pvginkel/Intercom/README.md

# TODO

- BLink lights during startup.
- Blink lights on failure.

# Pin assignment

PB = purple = 33
LR = orange = 18
LG = orange = 17

Speaker

LRC = green = 13
BCLK = blue = 14
SDI = yellow = 15

Microphone

WS = green = 35
SCK = blue = 36
SDO = yellow = 37
