pvginkel/Intercom/assets/3D Models/Body and microphone covers.3mf

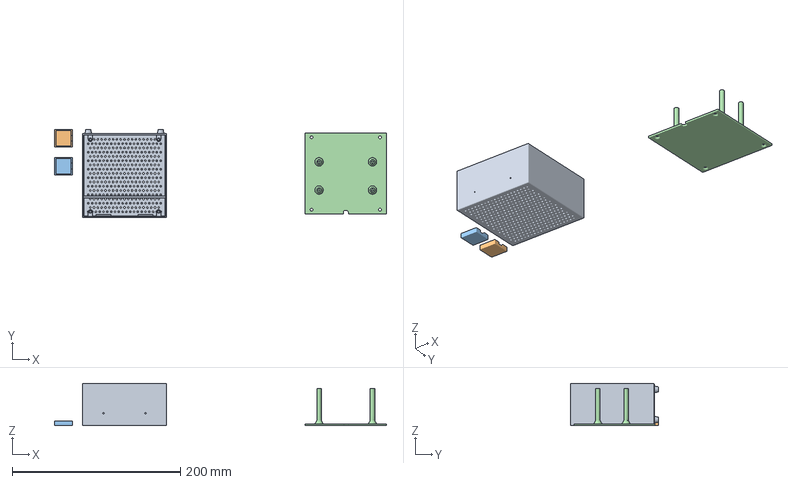
[picture p1: CAD file, 2025-03-16]
assets/3D Models/Body and microphone covers.3mf
394.6 x 105.0 x 50.0 mm
Body.stl
Microphone case left.stl x 2
Cover.stl
