pvginkel/Intercom/assets/3D Models/Body and microphone covers - 2.3mf

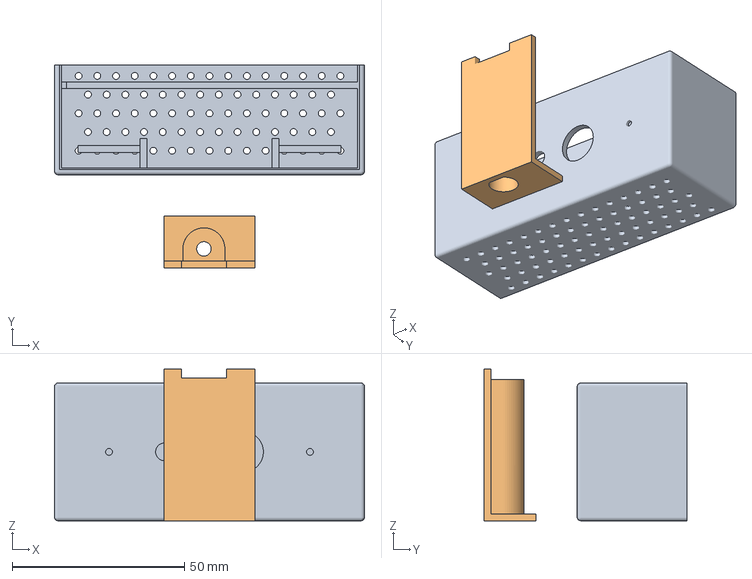
[picture p2: CAD file, 2025-03-16]
assets/3D Models/Body and microphone covers - 2.3mf
90.0 x 58.8 x 44.0 mm
Body1x.stl
Body1.stl
