pvginkel/Intercom/assets/3D Models/Jig for the controls.stl

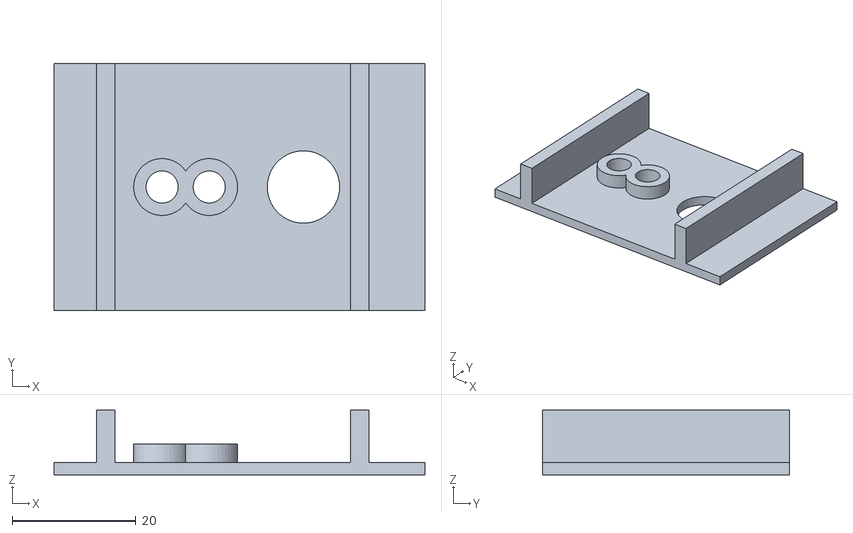
[picture p3: CAD file, 2025-03-16]
assets/3D Models/Jig for the controls.stl
60.0 x 40.0 x 10.5
