pvginkel/Intercom/assets/3D Models/Microphone case left.stl

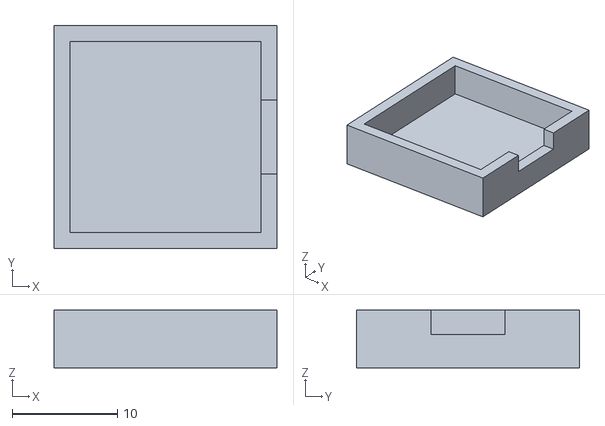
[picture p4: CAD file, 2025-02-15]
assets/3D Models/Microphone case left.stl
21.2 x 21.2 x 5.50
