pvginkel/Intercom/assets/3D Models/Body.stl

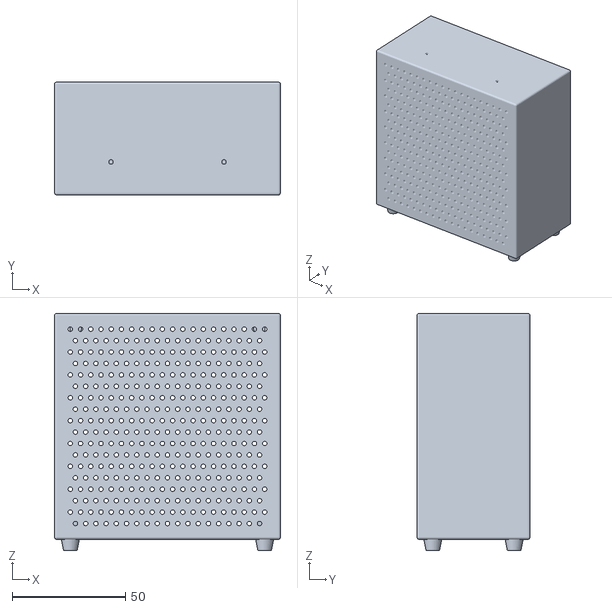
[picture p5: CAD file, 2025-02-15]
assets/3D Models/Body.stl
100.0 x 50.0 x 105.0
