pvginkel/Intercom/assets/3D Models/Cover.stl

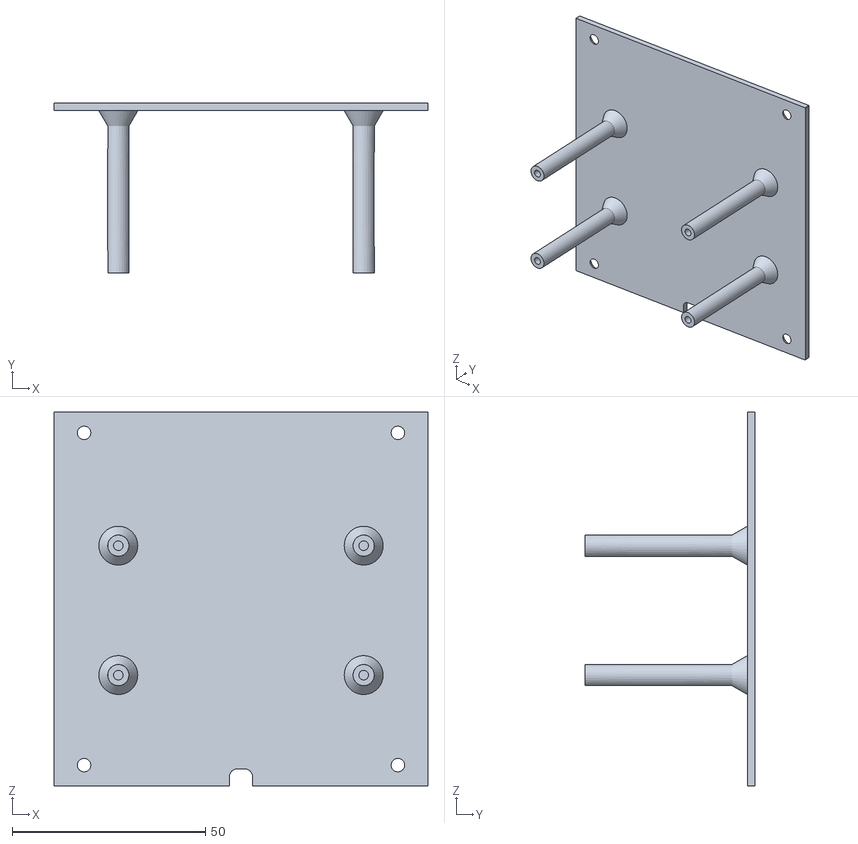
[picture p6: CAD file, 2025-02-15]
assets/3D Models/Cover.stl
96.8 x 44.0 x 96.8
