pvginkel/Intercom/assets/Boards/Control/Control.kicad_pcb

## KiCad design assets/Boards/Control/Control.kicad_pcb (2026-06-02)

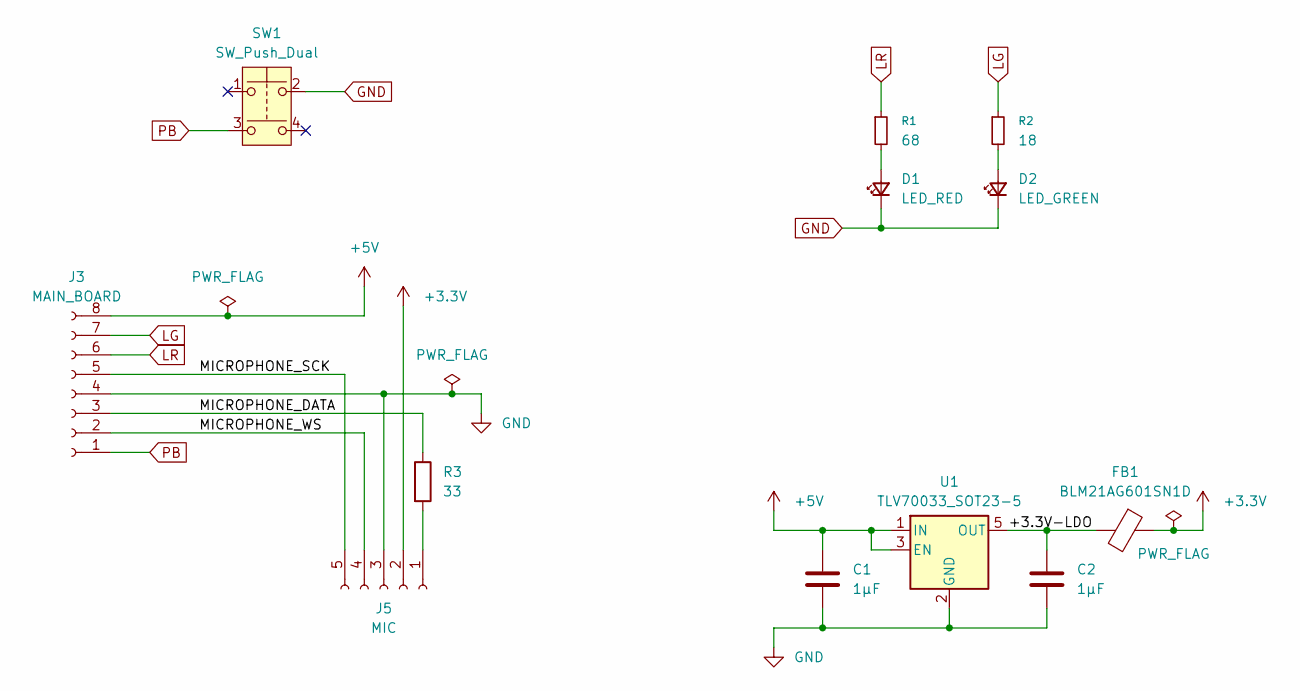
[picture p7: schematic Control.kicad_sch]

Parts:
C1, C2: 1µF; C_0805_2012Metric_Pad1.18x1.45mm_HandSolder
D1: LED_RED; LED_D5.0mm_Clear
D2: LED_GREEN; LED_D5.0mm_Clear
FB1: BLM21AG601SN1D; L_0805_2012Metric_Pad1.15x1.40mm_HandSolder
J3: MAIN_BOARD; JST_PH_S8B-PH-K_1x08_P2.00mm_Horizontal
J5: MIC; JST_PH_S5B-PH-K_1x05_P2.00mm_Horizontal
R1: 68; R_0805_2012Metric_Pad1.20x1.40mm_HandSolder
R2: 18; R_0805_2012Metric_Pad1.20x1.40mm_HandSolder
R3: 33; R_0805_2012Metric_Pad1.20x1.40mm_HandSolder
SW1: SW_Push_Dual; Pushbutton 12x12x7.3
U1: TLV70033_SOT23-5; SOT-23-5

Connections:
+3.3V: FB1.1, J5.2
+5V: C1.2, J3.8, U1.1 (IN), U1.3 (EN)
/+3.3V-LDO: C2.1, FB1.2, U1.5 (OUT)
/MICROPHONE_DATA: J3.3, R3.1
/MICROPHONE_SCK: J3.5, J5.5
/MICROPHONE_WS: J3.2, J5.4
GND: C1.1, C2.2, D1.1 (K), D2.1 (K), J3.4, J5.3, SW1.2, U1.2 (GND)
LG: J3.7, R2.1
LR: J3.6, R1.1
unnamed: D1.2 (A), R1.2
unnamed: D2.2 (A), R2.2
unnamed: J5.1, R3.2
PB: J3.1, SW1.3

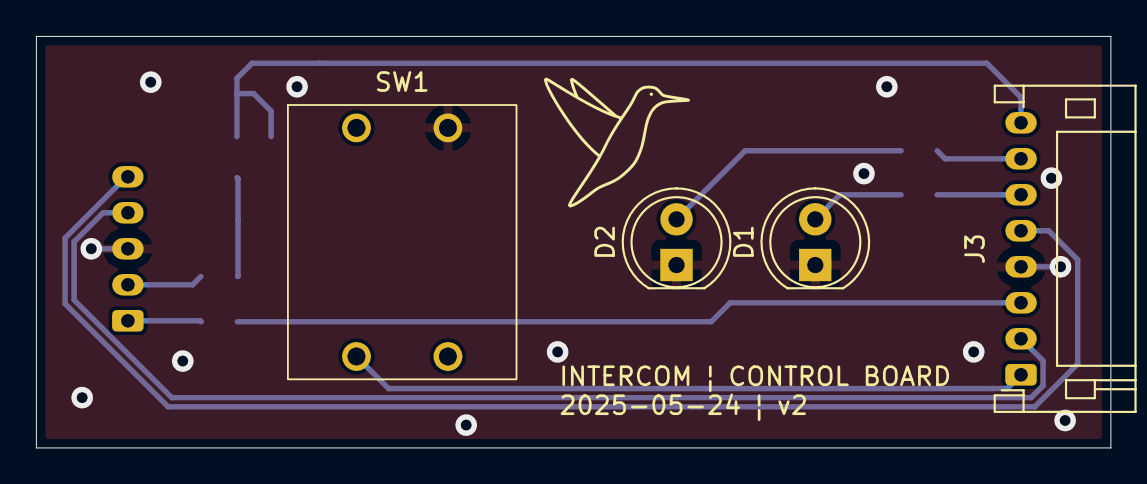
[picture p8: board Control.kicad_pcb from above]

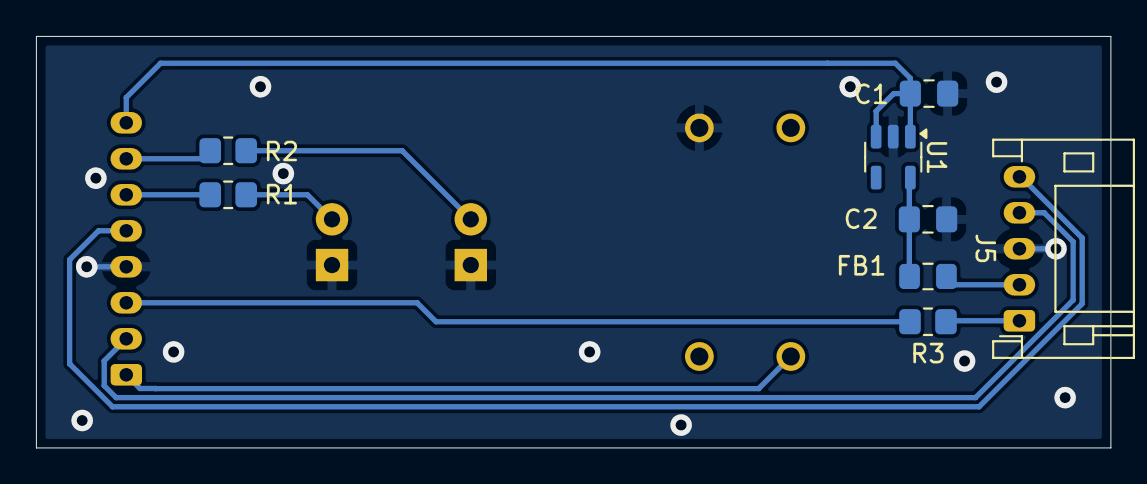
[picture p9: board Control.kicad_pcb from below]

Board: 2 copper layers, 59.7 x 22.9 mm, 12 parts (8 on the bottom side), 13 nets.
