pvginkel/Intercom/assets/Boards/Main/Main.kicad_pcb

## KiCad design assets/Boards/Main/Main.kicad_pcb (2026-06-02)

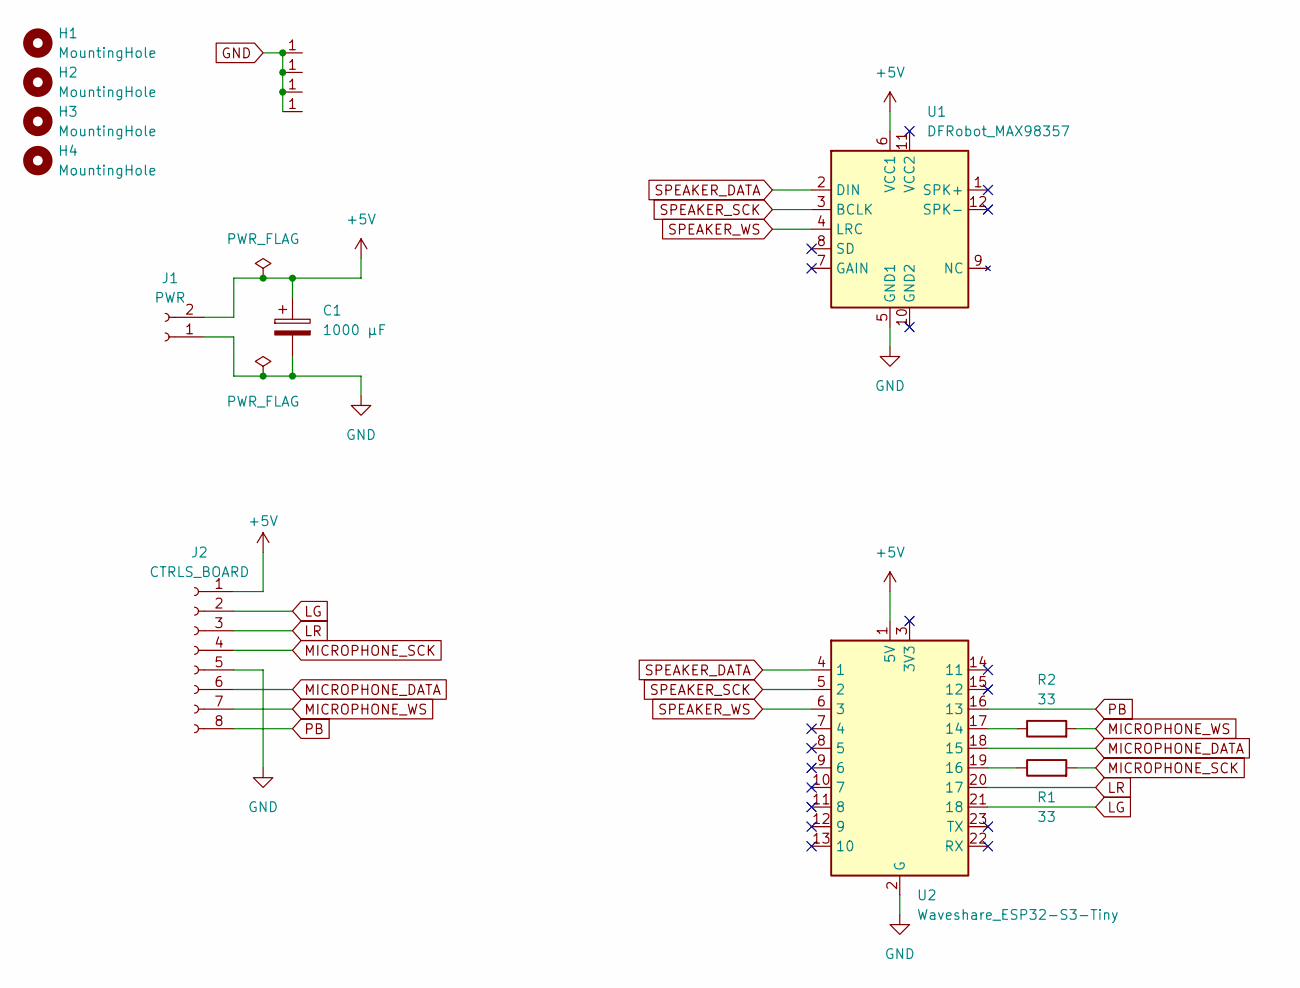
[picture p10: schematic Main.kicad_sch]

Parts:
C1: 1000 µF; CP_Radial_D10.0mm_P5.00mm
H1, H2, H3, H4: MountingHole; MountingHole_2.2mm_M2_DIN965
J1: PWR; JST_PH_B2B-PH-K_1x02_P2.00mm_Vertical
J2: CTRLS_BOARD; JST_PH_B8B-PH-K_1x08_P2.00mm_Vertical
R1, R2: 33; R_0805_2012Metric_Pad1.20x1.40mm_HandSolder
U1: DFRobot_MAX98357; DFRobot_MAX98357_SMD
U2: Waveshare_ESP32-S3-Tiny; Waveshare_ESP32-S3-Tiny_SMD
U3, U4, U5, U8: Solder pad 1.6x3.3mm

Connections:
+5V: C1.1, J1.2, J2.1, U1.6 (VCC1), U1.11 (VCC2), U2.1 (5V)
GND: C1.2, J1.1, J2.5, U1.5 (GND1), U1.10 (GND2), U2.2 (G), U3.1, U4.1, U5.1, U8.1
LG: J2.2, U2.21 (18)
LR: J2.3, U2.20 (17)
MICROPHONE_DATA: J2.6, U2.18 (15)
MICROPHONE_SCK: J2.4, R1.2
MICROPHONE_WS: J2.7, R2.2
unnamed: R2.1, U2.17 (14)
unnamed: R1.1, U2.19 (16)
PB: J2.8, U2.16 (13)
SPEAKER_DATA: U1.2 (DIN), U2.4 (1)
SPEAKER_SCK: U1.3 (BCLK), U2.5 (2)
SPEAKER_WS: U1.4 (LRC), U2.6 (3)

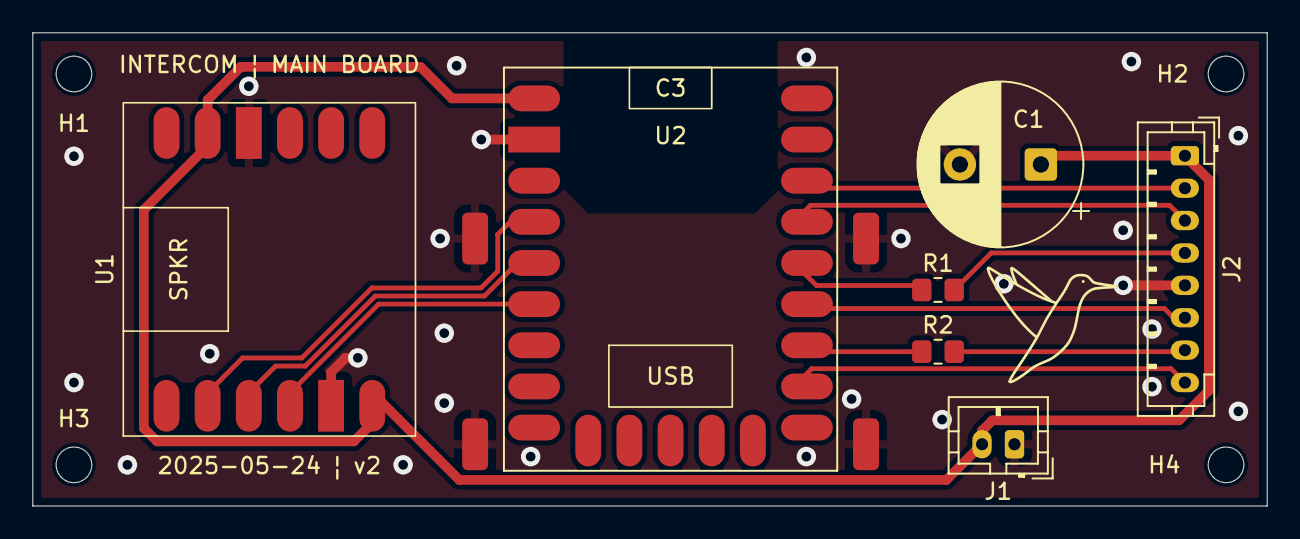
[picture p11: board Main.kicad_pcb from above]

Board: 2 copper layers, 76.2 x 29.2 mm, 15 parts (0 on the bottom side), 13 nets.
