pvginkel/Intercom/(commit log)

2025-02-15 Added 3D models.
    [Body and microphone covers.3mf, Body.stl, Cover.stl, Microphone case left.stl]
2025-03-16 Initial ESP-IDF project commit.
    [Body and microphone covers - 2.3mf, Body and microphone covers.3mf, Body.stl, Cover.stl, Jig for the controls.stl, Microphone case left.stl, partitions.csv]
2025-03-22 Got a minimally functional device to work.
2025-03-28 Updated INMP441 implementation.
    See https://github.com/pvginkel/INMP441Test for more information.
    [partitions.csv]
2025-04-13 Added PCB board.
    [Control.kicad_pcb, Control.kicad_sch, Main.kicad_pcb, Main.kicad_sch]
2025-04-13 Reconfigured for the real PCB board.
2025-04-13 Stream audio over UDP, fixed AEC.
    [partitions.csv]
2025-04-20 Removed support for the bootstrapper app.
    [partitions.csv]
2025-04-27 Rotated capacitor.
    [Main.kicad_pcb]
2025-04-28 Moved MQTT configuration into the device configuration file.
2025-05-01 Fade led on startup.
2025-05-02 Minor fixes to improve MQTT startup sequence.
    [Application.cpp, Application.h, Device.cpp]
2025-05-11 Improved NVS handling of the device.
2025-05-14 Set max WiFi transmission power.
2025-05-14 Updated WiFi defaults to correspond to the ESP32-S3 Tiny SOC.
2026-05-27 Added PowerShell upload script.
2026-06-02 Added ground plane, RF shield soldering points and text.
    [Control.kicad_pcb, Main.kicad_pcb, Main.kicad_sch]
2026-06-02 Reworked boards.
    Added LDO for the mic. Changed layout of the main board to move the cap out of the way. Added ground and power plane. Added R33's for the signal lines of the mic.
    [Control.kicad_pcb, Control.kicad_sch, Main.kicad_pcb, Main.kicad_sch]
2026-06-02 Fixed ERC errors. Switched to double ground plane instead of ground and power plane. Switched to 1uF caps for the LDO conforming to the data sheet. Added logo.
    [Control.kicad_pcb, Control.kicad_sch, Main.kicad_pcb, Main.kicad_sch]
2026-06-02 Applied suggestions from Rick Hartley.
    See https://www.youtube.com/watch?v=ySuUZEjARPY.
    [Control.kicad_pcb, Control.kicad_sch, Main.kicad_pcb, Main.kicad_sch]
2026-06-02 Applied suggestions from people from the KiCad forum.
    [Control.kicad_pcb, Control.kicad_sch, Main.kicad_pcb, Main.kicad_sch]
2026-06-02 Updated boards.
    [Control.kicad_pcb, Main.kicad_pcb]
2026-06-02 Create storage NVM when missing.
    [Device.cpp]
2026-06-02 Pin IDF target.
2026-06-02 Fix CI build: pin esp-sr and make AFE handle const-correct.
    CI re-solves dependencies (path-based esp-libs come from a moving
    main, so the committed lock's manifest_hash never matches), which
    pulled esp-sr 2.4.6 instead of the locally tested 2.0.3. In 2.4.6
    esp_afe_handle_from_config returns a const pointer.
    - Pin esp-sr to ==2.4.6 so local and CI resolve the same version.
    - Make _afe_handle a const esp_afe_sr_iface_t* (compiles against
    both 2.0.3 and 2.4.6).
    [I2SRecordingDevice.h]
2026-06-05 docs/architecture: split intercom firmware into v1 and v2 products
    The build now emits two firmware artifacts, one per board revision:
    intercom_v1 and intercom_v2 (CMakeLists `project(intercom_v${HARDWARE_VERSION})`,
    Jenkins builds+deploys both HARDWARE_VERSION 1 and 2). v2 has identical
    functionality, targeting the new hardware revision.
    Rename the existing «SoftwareProduct» to `ss:intercom-v1` (UUID unchanged)
    and add `ss:intercom-v2,bf17d137-676b-464a-ad5a-3460602766e6` with the same
    consumption edges (IoT Support, pub/sub, IAM, intercom relay, HA MQTT). Each
    relation is duplicated per firmware; the rename also carries the v1 edges'
    source/id over.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
2026-06-05 docs/architecture: realize cap:iot-device (v1 + v2)
    Tag this firmware as an IoT device — the selection axis for the IoT view in the
    Architecture model (Phase 1). The cap:iot-device enum entry is live in the
    Architecture repo.
2026-06-05 Vary WiFi TX power per hardware version.
2026-06-05 Throttle error messages from UDPServer.
    [UDPServer.cpp, UDPServer.h]
2026-06-07 Fixed MQTT discovery publication.
    [Application.cpp]
2026-09-06 Onboard into KubeCoder: config.yaml and project.yaml.
    config.yaml brings esp-libs alongside as a shared, reference-only checkout —
    the build reaches for it from two places (../esp-libs/<c>/sdkconfig.defaults in
    the top-level CMakeLists.txt, ../../esp-libs/<c> path dependencies in
    main/idf_component.yml), which is the layout the Jenkinsfile arranges too — and
    selects the esp-idf toolchain, ESP-IDF 5.5.3, matching the espressif/idf:v5.5.3
    that CI pins.
    project.yaml declares one component. `build` builds both hardware revisions,
    each into its own directory so both stay incremental; `lint` runs the
    architecture validator Jenkinsfile.architecture runs. `test` is left unset:
    there is no suite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
